Magnum164/kv4p-ht/3d-print-case/alternate case designs/PCB slide-in case with stand/KV4P HT Case v1.6 - MAIN BODY.stl

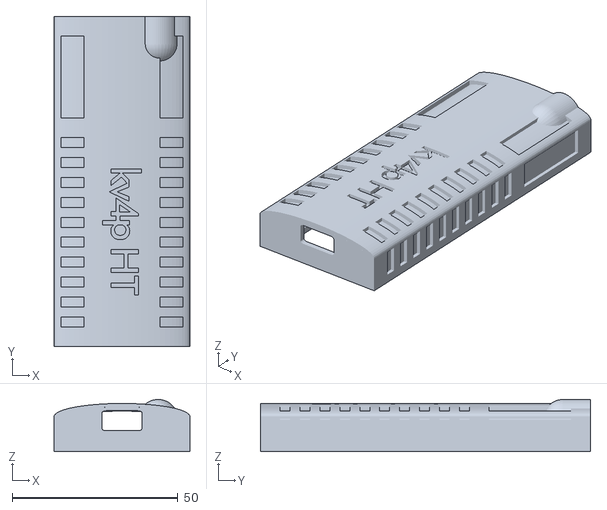
[picture p1: CAD file, 2024-12-06]
3d-print-case/alternate case designs/PCB slide-in case with stand/KV4P HT Case v1.6 - MAIN BODY.stl
41.0 x 99.6 x 15.7
