Magnum164/kv4p-ht/3d-print-case/alternate case designs/PCB slide-in case with stand/KV4P HT Stand.stl

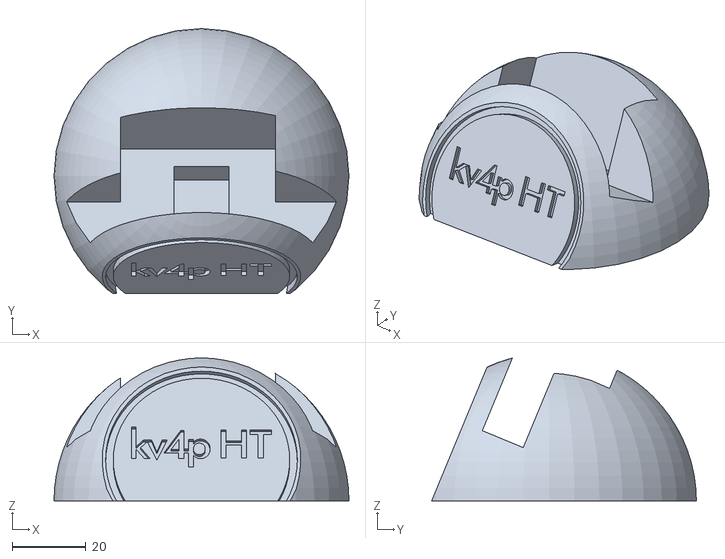
[picture p2: CAD file, 2024-12-06]
3d-print-case/alternate case designs/PCB slide-in case with stand/KV4P HT Stand.stl
80.0 x 71.8 x 38.7
