Magnum164/kv4p-ht/3d-print-case/alternate case designs/Quad lock case/KV4P-HT Quad Lock Add-Ons.stl

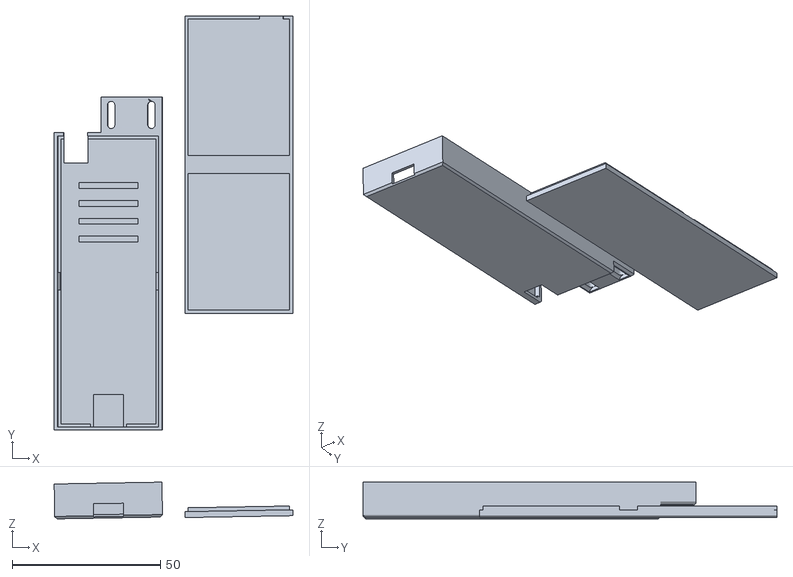
[picture p3: CAD file, 2024-12-06]
3d-print-case/alternate case designs/Quad lock case/KV4P-HT Quad Lock Add-Ons.stl
80.6 x 139.8 x 12.4
