Magnum164/kv4p-ht/3d-print-case/alternate case designs/Sleek without USB connector holder/Sleek KV4P HT inlay.stl

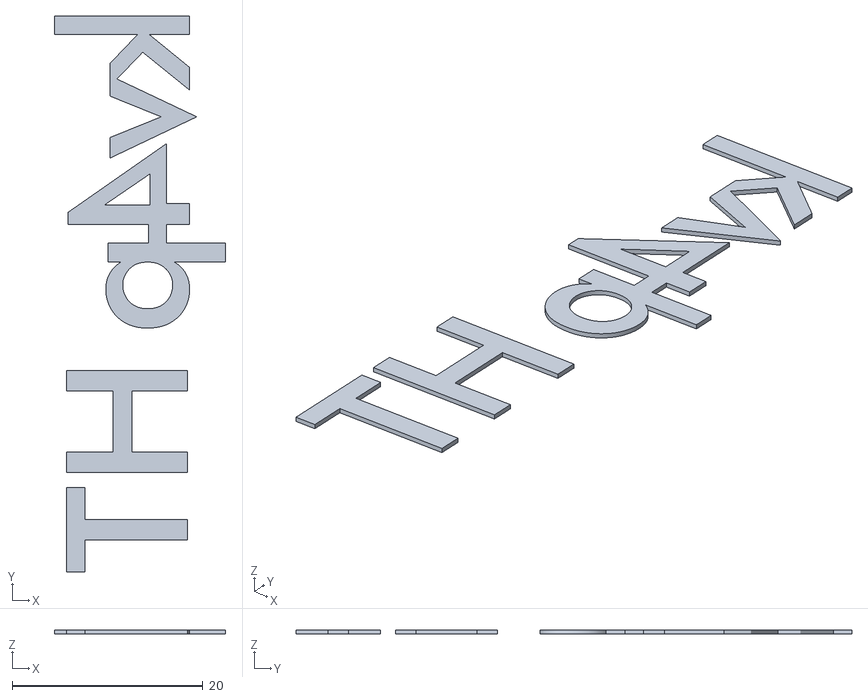
[picture p4: CAD file, 2024-12-06]
3d-print-case/alternate case designs/Sleek without USB connector holder/Sleek KV4P HT inlay.stl
18.0 x 58.3 x 0.4
