Magnum164/kv4p-ht/3d-print-case/alternate case designs/Thicker body (JLCPCB compliant)/KV4P HT Case Thicker Body.stl

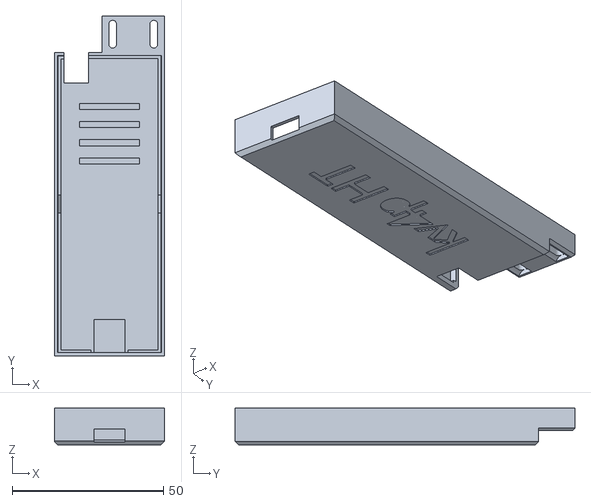
[picture p5: CAD file, 2024-12-06]
3d-print-case/alternate case designs/Thicker body (JLCPCB compliant)/KV4P HT Case Thicker Body.stl
36.4 x 112.4 x 12.2
