Magnum164/kv4p-ht/3d-print-case/V2 Case Designs/kv4p-ht V2 case.step

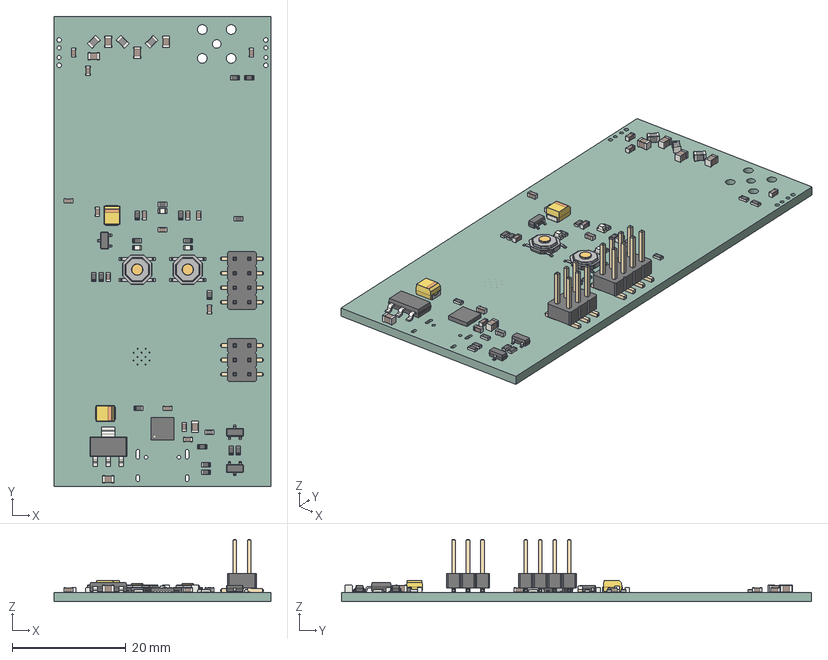
[picture p6: CAD file, 2024-11-08]
3d-print-case/V2 Case Designs/kv4p-ht V2 case.step
38.1 x 82.6 x 11.0 mm
LED_0603_1608Metric x 3
CP_EIA_3528_21_Kemet_B x 2
C_0603_1608Metric x 18
C_0805_2012Metric x 6
R_0603_1608Metric x 17
L_0603_1608Metric x 4
SOT_23 x 3
L_0805_2012Metric x 3
SW_SPST_TL3342 x 2
PinHeader_2x03_P254mm_Vertical_SMD
PinHeader_2x04_P254mm_Vertical_SMD
QFN-24-1EP_4x4mm_Pitch0.5mm
SOT_223
kv4p-ht (2)_PCB
