Magnum164/kv4p-ht/3d-print-case/alternate case designs/Sleek without USB connector holder/Sleek KV4P HT case.stl

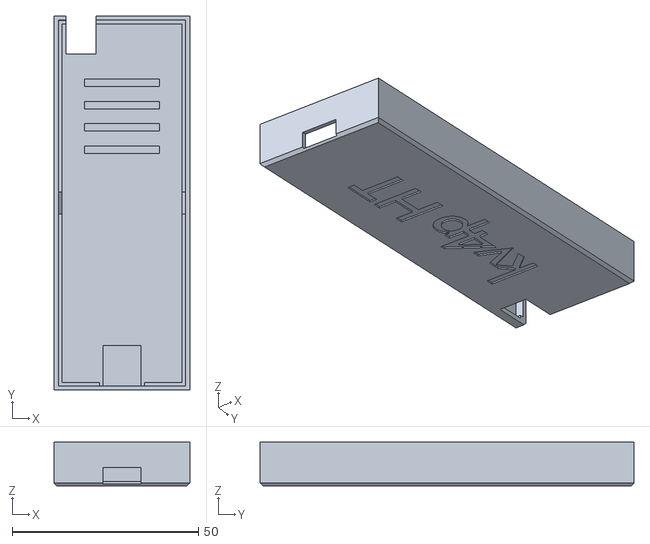
[picture p7: CAD file, 2024-12-06]
3d-print-case/alternate case designs/Sleek without USB connector holder/Sleek KV4P HT case.stl
36.4 x 100.4 x 11.8
