Magnum164/kv4p-ht/3d-print-case/alternate case designs/PCB slide-in case with stand/KV4P HT Case v1.6 - TOP.stl

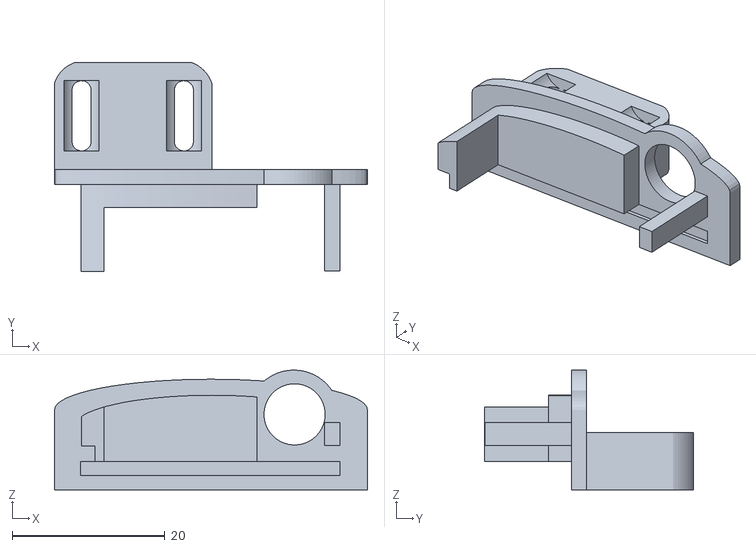
[picture p8: CAD file, 2024-12-06]
3d-print-case/alternate case designs/PCB slide-in case with stand/KV4P HT Case v1.6 - TOP.stl
41.0 x 27.4 x 15.7
