Magnum164/kv4p-ht/pcb/KiCAD/kv4p-ht/kv4p-ht.kicad_pcb

## KiCad design pcb/KiCAD/kv4p-ht/kv4p-ht.kicad_pcb (2024-12-06)

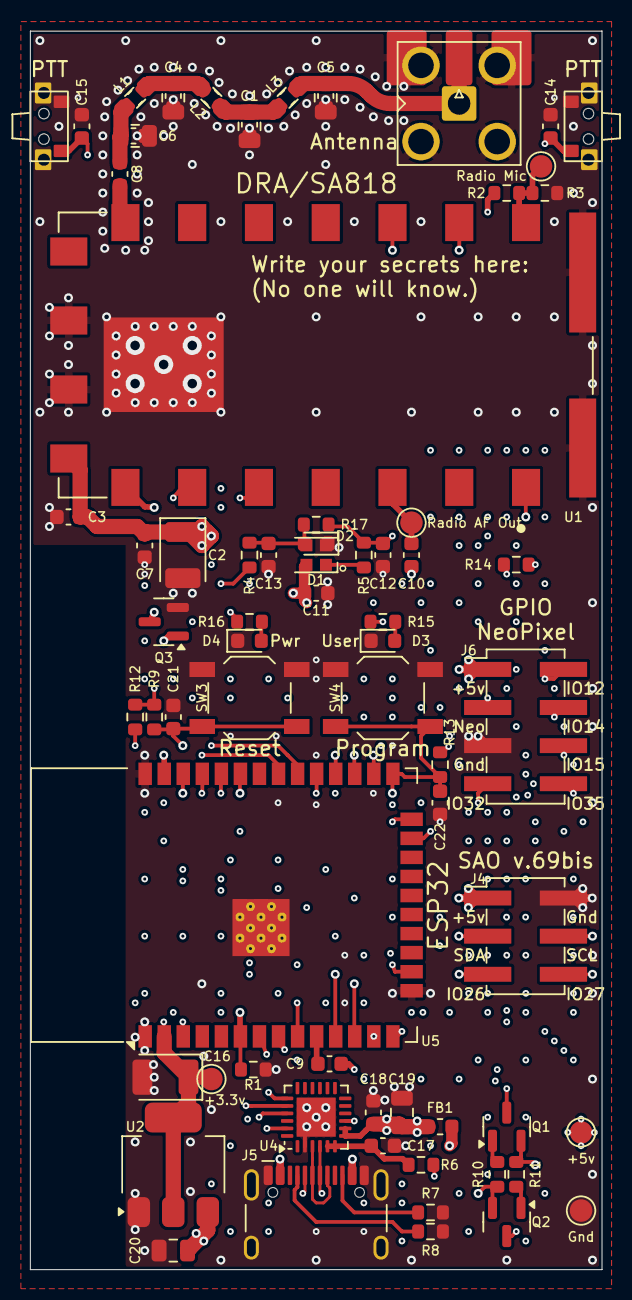
[picture p9: board kv4p-ht.kicad_pcb from above]

Board: 4 copper layers, 38.1 x 82.6 mm, 75 parts (0 on the bottom side), 53 nets.

Parts:
C1, C4: 43pF; C_0805_2012Metric
C2, C16: 100uF 6.3v; CP_EIA-3528-21_Kemet-B
C3, C8, C12, C13, C14, C15, C21, C22: 2.2nF Tuned VHF; C_0603_1608Metric
C5, C6: 24pF; C_0805_2012Metric
C7, C11, C18: 100nF; C_0603_1608Metric
C9, C10, C17: 1uF; C_0603_1608Metric
C19, C20: 10uF; C_0805_2012Metric
C23, C24, C25, C26: C_0603_1608Metric
D1: SK6812-EC20; LED_WS2812B-2020_PLCC4_2.0x2.0mm
D2, D3, D4: Red; LED_0603_1608Metric
FB1: Ferrite Bead, 1A; L_0603_1608Metric
J1: Antenna; SMA_Amphenol_901-143_Horizontal
J2: SMA; SMA_Molex_73251-2120_EdgeMount_Horizontal
J4: SAO v.69bis; PinHeader_2x03_P2.54mm_Vertical_SMD
J5: USB-C Socket; USB_C_Receptacle_HCTL_HC-TYPE-C-16P-01A
J6: GPIO Header; PinHeader_2x04_P2.54mm_Vertical_SMD
L1, L3: 75nH; L_0805_2012Metric
L2: 83nH; L_0603_1608Metric
L4, L6: L_0603_1608Metric
L5: L_0805_2012Metric
Q1, Q2: SS8050; SOT-23
Q3: AO3400A; SOT-23
R1, R2, R9, R10, R11, R12, R13, R14: 10k; R_0603_1608Metric
R3, R6, R16: 1k; R_0603_1608Metric
R4, R5: 100R; R_0603_1608Metric
R7, R8: 5.1k; R_0603_1608Metric
R15: 470R; R_0603_1608Metric
R17: 0R; R_0603_1608Metric
SW1, SW2: PTT; SW-Push-SPST-Horizontal-C381061
SW3: Reset; SW_SPST_TL3342
SW4: Program; SW_SPST_TL3342
TP1: +5v; TestPoint_Pad_D1.5mm
TP2: +3.3v; TestPoint_Pad_D1.5mm
TP3: Gnd; TestPoint_Pad_D1.5mm
TP4: Radio Mic; TestPoint_Pad_D1.5mm
TP5: Radio AF Out; TestPoint_Pad_D1.5mm
U1: DRA/SA818; DRA818V_DORJI_DRA818V
U2: AZ1117H-3.3TRG1; SOT-223-3_TabPin2
U4: CP2102N-A02-GQFN24; QFN-24-1EP_4x4mm_P0.5mm_EP2.6x2.6mm
U5: ESP32-WROOM-32E; ESP32-WROOM-32D

Connections:
+3.3V: C16.1, R9.2, R12.2, R13.2, R14.2, TP2.1, U2.2 (VO), U5.2 (VDD)
+5V: C2.1, C3.1, C7.1, C11.1, C18.1, C19.2, C20.2, D1.4 (VDD), FB1.2, J4.1, J6.1, R16.1, TP1.1, U1.8 (VBAT), U2.3 (VI), U4.7 (VREGIN), U4.8 (VBUS)
/Enable/~Reset: C21.1, Q1.3 (C), R9.1, SW3.1 (A), U5.3 (EN)
/GPIO0/~Program: C22.1, Q2.3 (C), R13.1, SW4.1 (A), U5.25 (IO0)
/GPIO12: J6.2, U5.14 (IO12)
/GPIO14: J6.4, U5.13 (IO14)
/GPIO15: J6.6, U5.23 (IO15)
/GPIO32: J6.7, U5.8 (IO32)
/GPIO35: J6.8, U5.7 (IO35)
/NeoPixel DI: R4.1, U5.16 (IO13)
/NeoPixel DO: C12.1, J6.3, R5.2, R17.2
/PTT Button Left: C15.1, R12.1, SW1.2, U5.9 (IO33)
/PTT Button Right: C14.1, R14.1, SW2.1, U5.29 (IO5)
/Radio AF Out: C10.2, TP5.1, U1.3 (AF_OUT)
/Radio Mic In: R2.1, R3.1, TP4.1, U1.18 (MIC_IN)
/Radio Power Hi-Z Hi/~Low: Q3.3 (D), U1.7 (H/L)
/Radio Rx: U1.16 (RXD), U5.28 (IO17)
/Radio Squelch Closed/~Open: U1.1 (SQ), U5.26 (IO4)
/Radio Tx: U1.17 (TXD), U5.27 (IO16)
/Radio ~PTT: U1.5 (PTT), U5.30 (IO18)
/Radio ~Power Down: U1.6 (PD), U5.31 (IO19)
/SAO GPIO0: J4.5, U5.11 (IO26)
/SAO GPIO1: J4.6, U5.12 (IO27)
/SAO SCK: J4.4, U5.36 (IO22)
/SAO SDA: J4.3, U5.33 (IO21)
/Stock LED: R15.1, U5.24 (IO2)
/USB Rx: U4.20 (RXD), U5.35 (TXD0/IO1)
/USB Tx: U4.21 (TXD), U5.34 (RXD0/IO3)
/~DTR: Q2.2 (E), R10.2, U4.23 (~DTR)
/~RTS: Q1.2 (E), R11.2, U4.19 (~RTS)
GND: C1.1, C2.2, C3.2, C4.1, C5.1, C6.1, C7.2, C11.2, C12.2, C13.2, C14.2, C15.2, C16.2, C17.2, C18.2, C19.1, C20.1, C21.2, C22.2, C23.1, C24.1, C25.1, C26.1, D1.2 (VSS), D2.1 (K), D3.1 (K), D4.1 (K), J1.2 (Ext), J2.2 (Ext), J4.2, J5.A1 (GND), J5.A12 (GND), J5.B1 (GND), J5.B12 (GND), J5.S1 (SHIELD), J6.5, Q3.2 (S), R1.1, R3.2, R7.2, R8.2, SW1.1, SW1.SH (B), SW2.2, SW2.SH (B), SW3.2 (B), SW4.2 (B), TP3.1, U1.9 (GND), U1.10 (GND), U1.P1 (Pads), U1.P2 (Pads), U1.P3 (Pads), U2.1 (GND), U4.2 (GND), U4.25 (GND), U5.1 (GND), U5.15 (GND), U5.38 (GND), U5.39 (GND)
unnamed: C1.2, C24.2, L2.1, L3.2, L4.2, L5.1
unnamed: C9.1, R2.2
unnamed: C4.2, C25.2, L1.1, L2.2, L5.2, L6.1
unnamed: C6.2, C8.1, C26.2, L1.2, L6.2
unnamed: C13.1, D1.3 (DIN), D2.2 (A), R4.2, R17.1
unnamed: D1.1 (DOUT), R5.1
unnamed: D3.2 (A), R15.2
unnamed: D4.2 (A), R16.2
unnamed: C5.2, C23.2, J1.1 (In), J2.1 (In), L3.1, L4.1
unnamed: J5.A5 (CC1), R8.1
unnamed: J5.B5 (CC2), R7.1
unnamed: Q1.1 (B), R10.1
unnamed: Q2.1 (B), R11.1
unnamed: Q3.1 (G), U5.37 (IO23)
unnamed: C8.2, U1.12 (ANT)
unnamed: J5.A6 (D+), J5.B6 (D+), U4.3 (D+)
unnamed: J5.A7 (D-), J5.B7 (D-), U4.4 (D-)
unnamed: C17.1, R6.1, U4.5 (VIO), U4.6 (VDD)
unnamed: R6.2, U4.9 (~RST)
unnamed: C9.2, U5.10 (IO25)
unnamed: C10.1, R1.2, U5.6 (IO34)
VBUS: FB1.1, J5.A4 (VBUS), J5.A9 (VBUS), J5.B4 (VBUS), J5.B9 (VBUS)
