Magnum164/kv4p-ht/(commit log)

2024-11-08 Create kv4p-ht V2 case
    Need place to store case STEP and model files.
2024-11-08 V2 STEP file
    [kv4p-ht V2 case.step]
