Magnum164/kv4p-ht/(notices)

Notices in the files:
android-src/KV4PHT/app/src/main/java/com/vagell/kv4pht/radio/RadioAudioService.java:
This program is free software: you can redistribute it and/or modify
it under the terms of the GNU General Public License as published by
the Free Software Foundation, either version 3 of the License, or
(at your option) any later version.
